algomusic/lofi-sequencer/Photo - LoFi Generative Sequencer.jpg

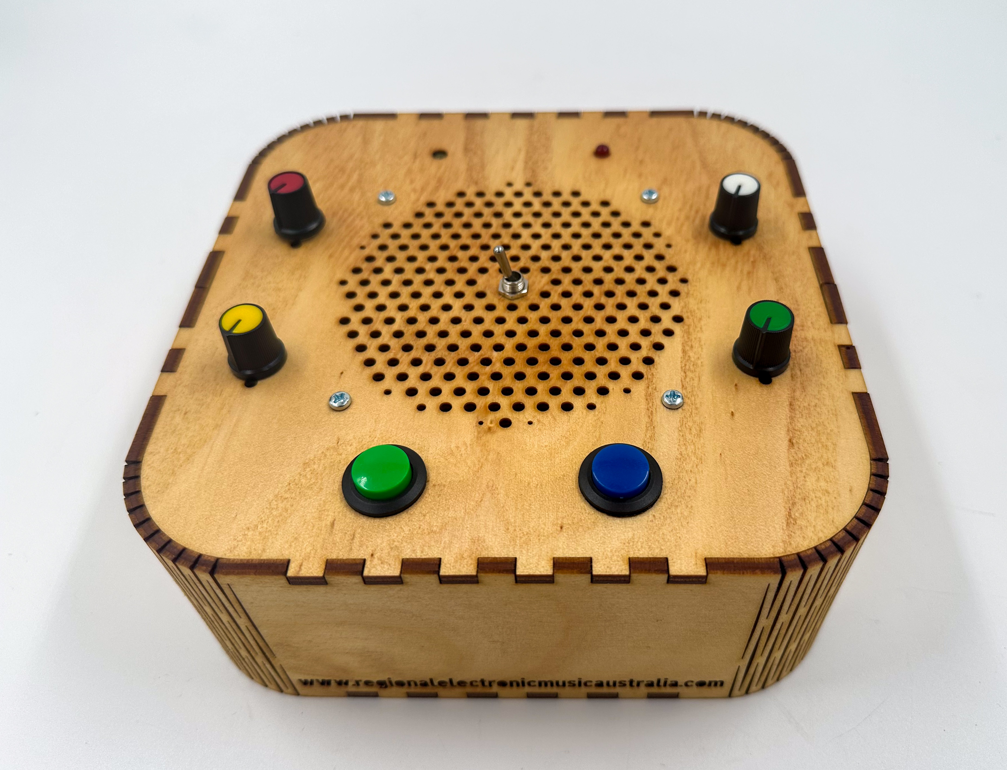
Photo - LoFi Generative Sequencer.jpg
