algomusic/lofi-sequencer/README.md

A simple DIY generative sequencer based on an ESP32 with a laser-cut enclosure.

The LoFi Generative Sequencer is a self-contained, DIY electronic musical instrument. It is battery-powered, with a built-in loudspeaker and headphone/line output, and driven by an ESP32 microcontroller. It can generate and playback repeated monophonic musical patterns up to 16 steps in length.

Interface controls include:

+ Buttons - Play, Generate / Shift
+ Dials - Timbre / Shape, Range / Octave, Volume / Tempo, Density / Length
+ Switch - Power
+ LEDs - Power, Metronome

This project uses [M8](https://github.com/algomusic/M8), an 8 Bit Arduino PWM audio library for the ESP32

The sProto version of the LoFi Sequnncer uses the [M16](https://github.com/algomusic/M16) audio library.

To flash the sProto version firmware use the [ESP Connnect](https://thelastoutpostworkshop.github.io/ESPConnect/) online tool.
