algomusic/lofi-sequencer/Schematic  - LoFi Generative Sequencer.png

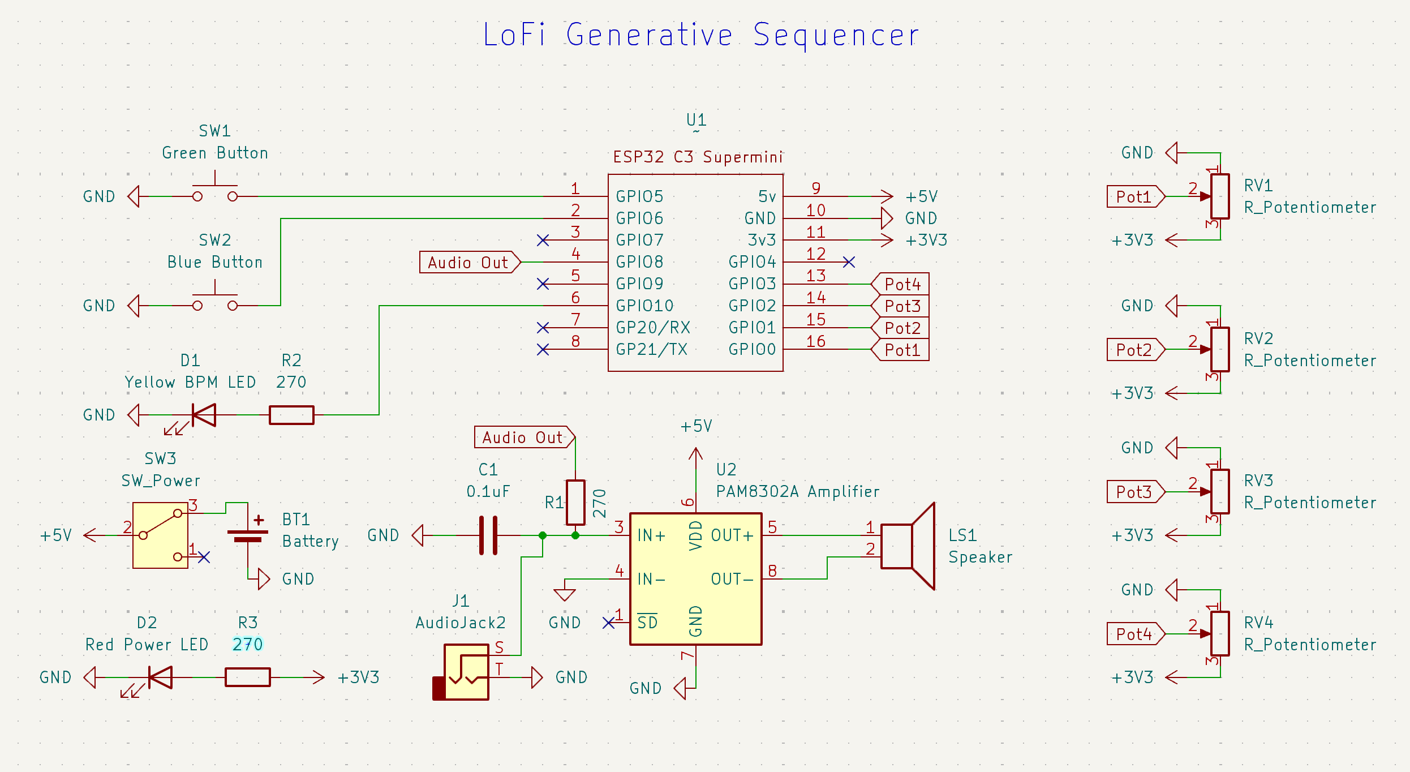
Schematic - LoFi Generative Sequencer.png
