algomusic/lofi-sequencer/(commit log)

2025-10-29 Source Code
    ESP32 Arduino Core and M8 Library required
2025-10-29 Laser cutting templates for the case
2025-10-29 Updated power and pins
2025-10-29 List of parts and suppliers
    [BOM - LoFi Sequencer.csv]
2025-11-13 Amp power now 5v
2025-11-13 Single resistor value
    Change to a 270 ohm resist for both LED and RC filter to minimise assembly confusion.
    [BOM - LoFi Sequencer.csv]
